TomaszBednorz/BLDC_Controller/Hardware/README.md

# Hardware - BLDC_Controller

Project designed in "Altium Designer" software. Involve custom BLDC motor controller and encoder based on Hall sensors.

## 1. Information
- The PMSM_Motor_Controller_v2_2023.pdf file contains the electrical schematics for BLDC controller,
- The Hall_board.pdf file contains the electrical schematics for encoder,
- The Altium_project directory contains the Altium designer project: electrical schematics, layout and more.

## 2. PCB sections
- Power supply,
- Microcontroller - Infineon XMC4300,
- EtherCAT,
- Gate driver,
- Encoder.

## 3. Visualization - BLDC controller
Front:

front

Back:

back

## 4. Visualisation - Custom encoder
Front:

front2

Back:

back2
