TomaszBednorz/BLDC_Controller/Software/README.md

# Software - BLDC_Controller

Dedicated software for the BLDC controller. **Software development is still in progress.**

## 1. TODO list
- [x] TMAG5170 Hall sensor driver
- [x] Motor position detection system
- [x] Hardware abstraction layers: Hall sensor, PWM, ADC
- [x] Motor control in the open loop control system - basic six-step commutation
- [ ] Motor control in the closed loop control system - PI controller
- [ ] Using BEMF (Back-electromotive force) in motor control system
