TomaszBednorz/BLDC_Controller/Hardware/Altium_project/PMSM_Motor_Controller_v2_2023.html

Reporting Options

# File in Newer Format

Date | : | 10.04.2023
Time | : | 15:40:49
Project name | : | C:\Users\Public\Documents\Altium\PMSM_Motor_Controller_v2_2023\PMSM_Motor_Controller_v2_2023.PrjPcb
Schematic documents | : | ECAT0_(IN).SchDoc

Version | Warning
22.3.0 | Custom diff pair suffixes are not supported in this version.

These files were generated in a later version of Altium Designer. Be aware that some data may have been added through functionality not available in your current version and will therefore not be available to you.
