TomaszBednorz/BLDC_Controller/Hardware/PMSM_Motor_Controller_v2_2023.pdf

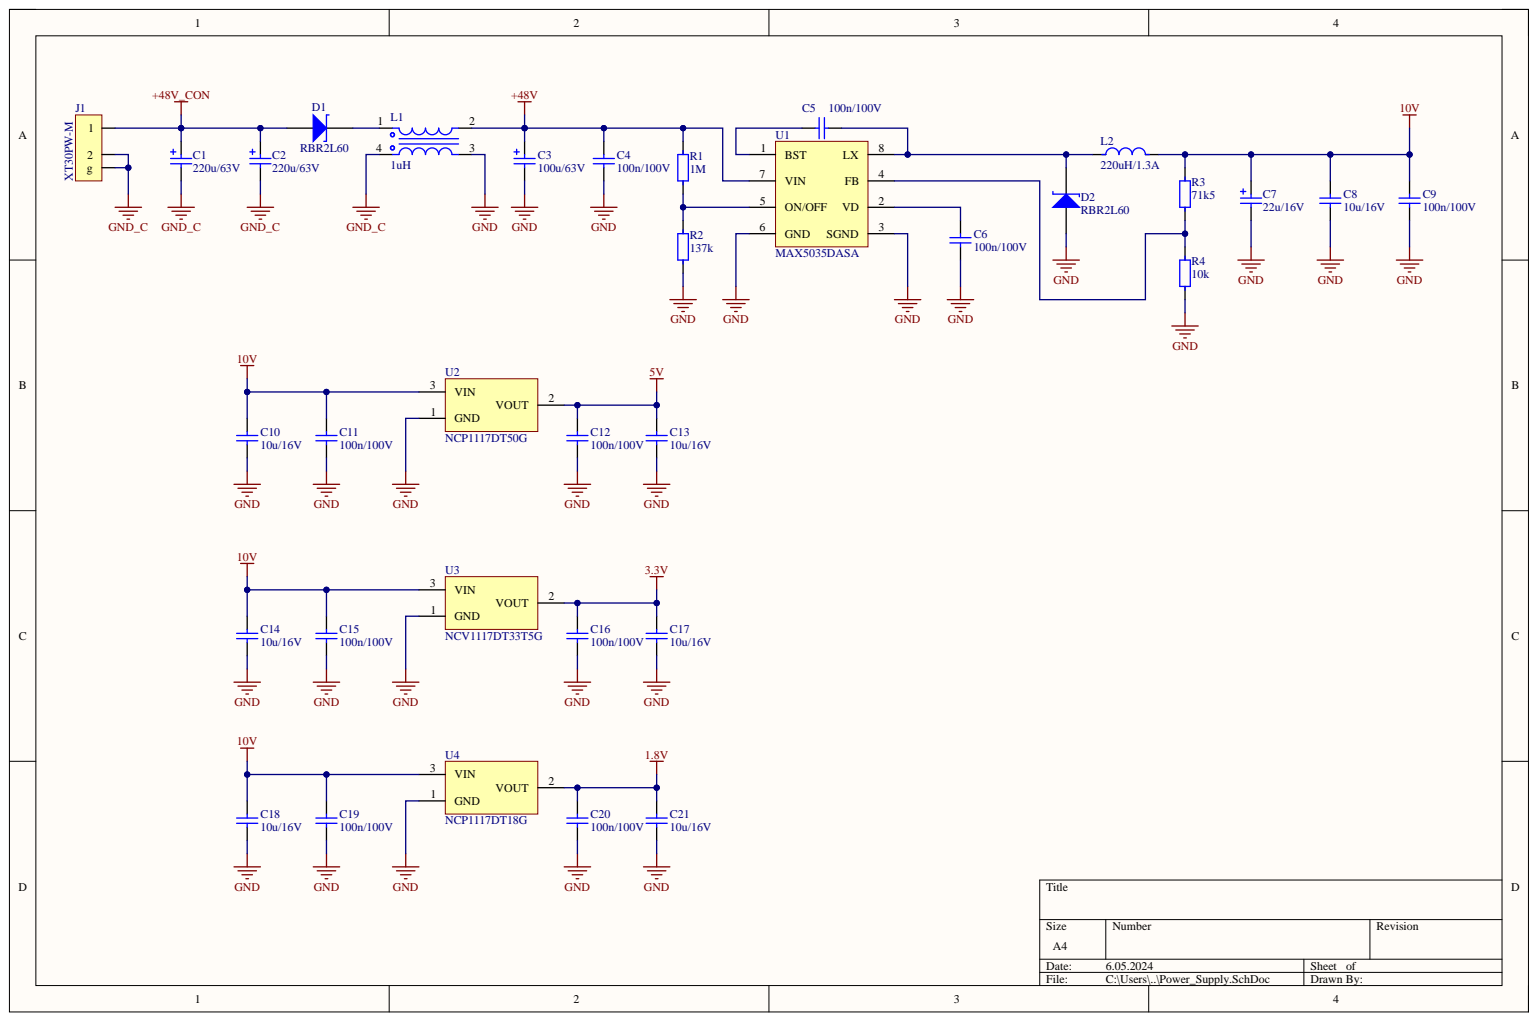
[picture p15: page 1]

VIN 7 VD

ON/OFF 5 | 2

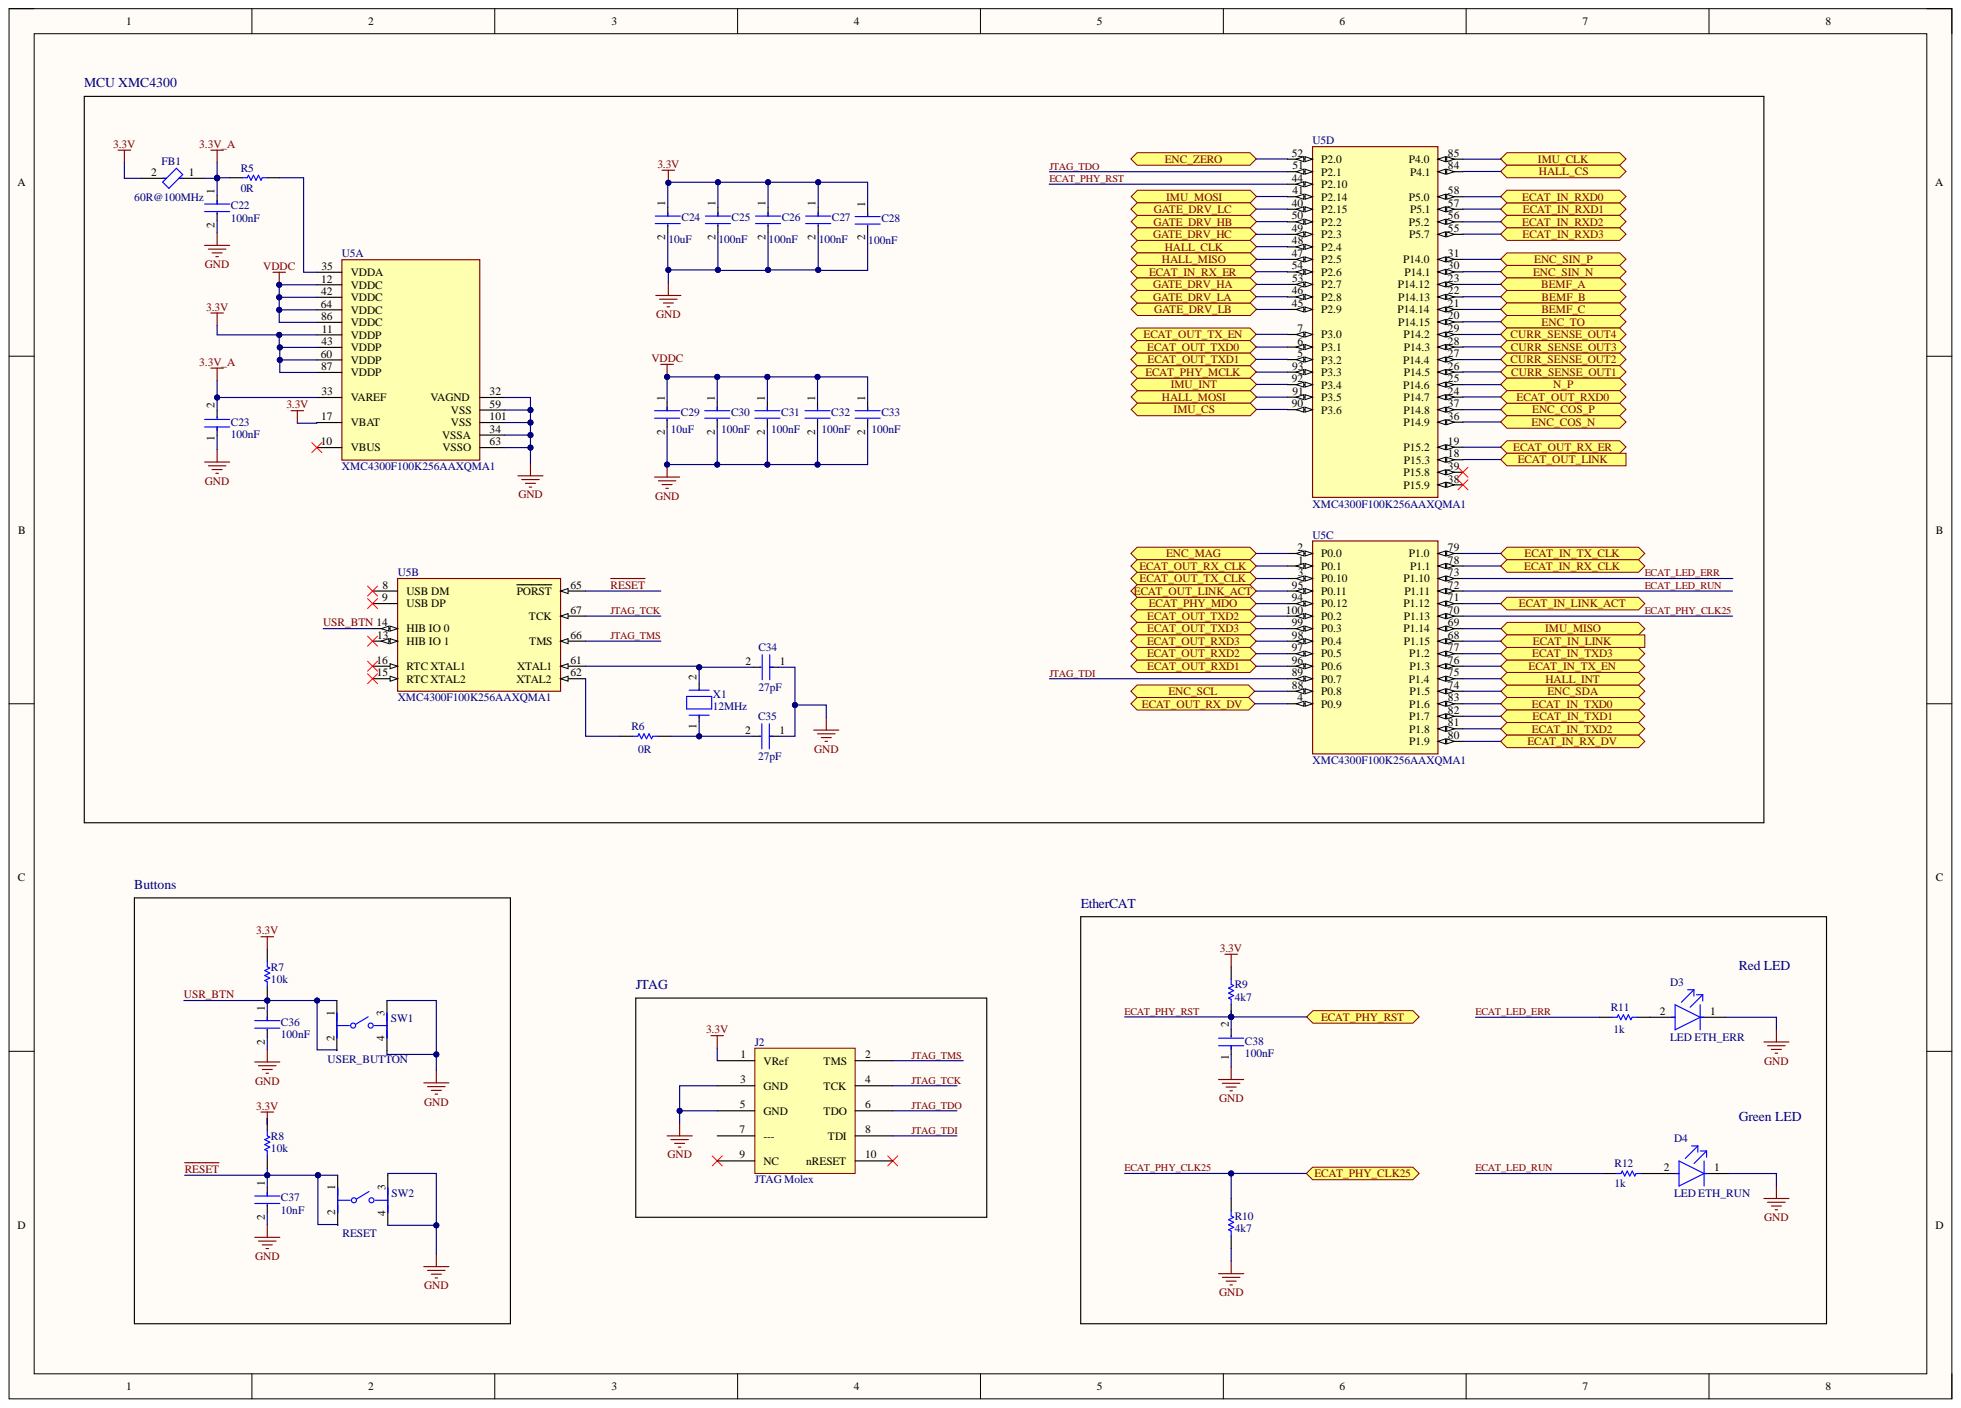
[picture p16: page 2]

VDDC 42
VDDC 64 | GND VDDC

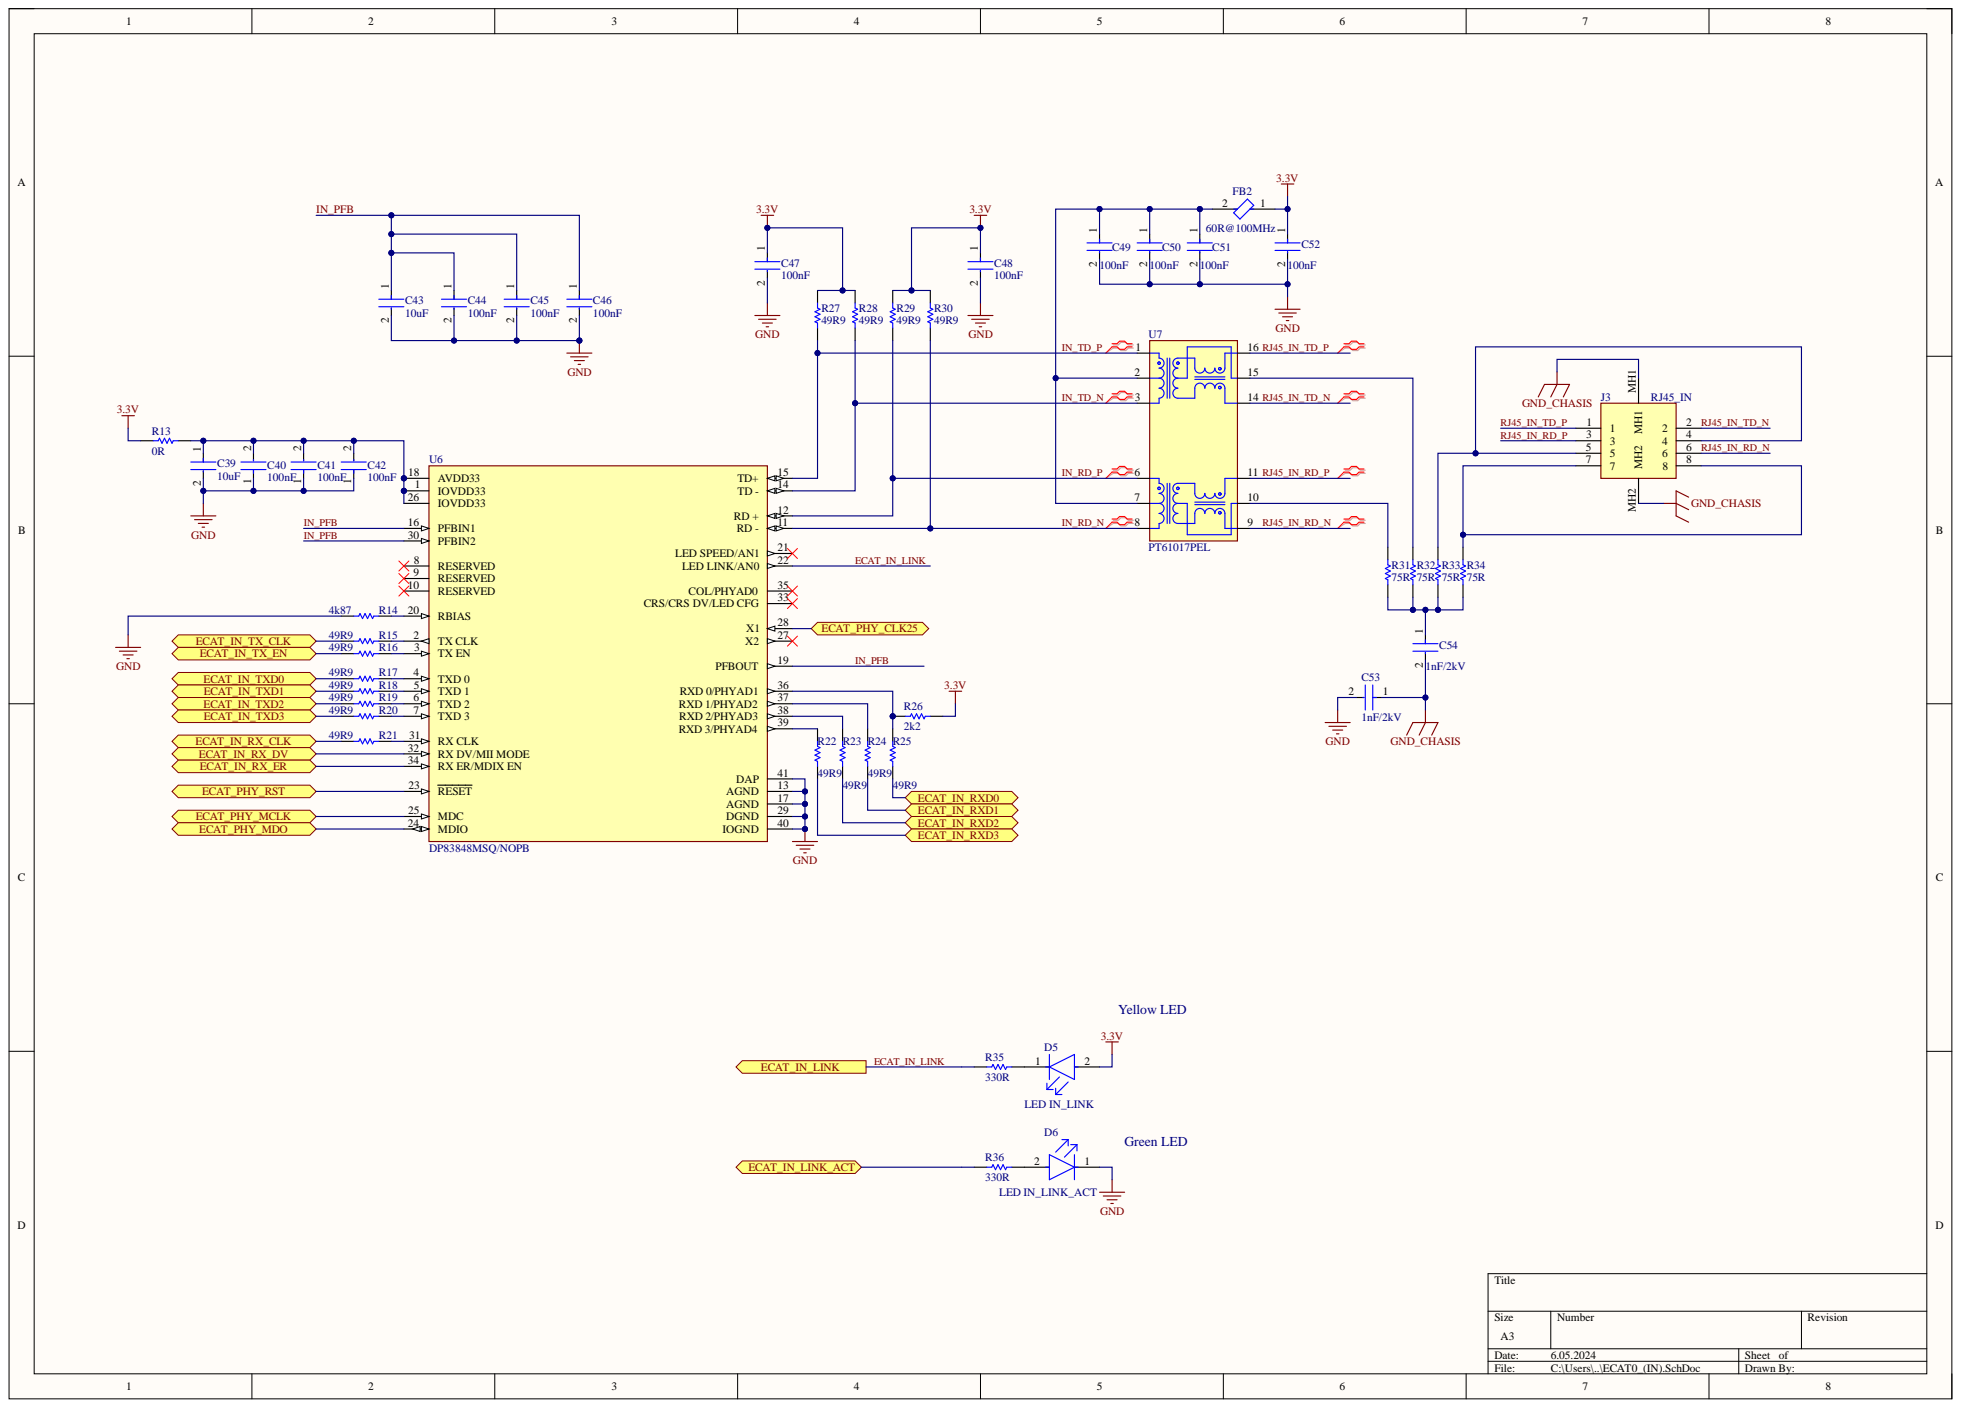
[picture p17: page 3]

RX CLK 31
RX DV/MII MODE 32
RX ER/MDIX EN 34

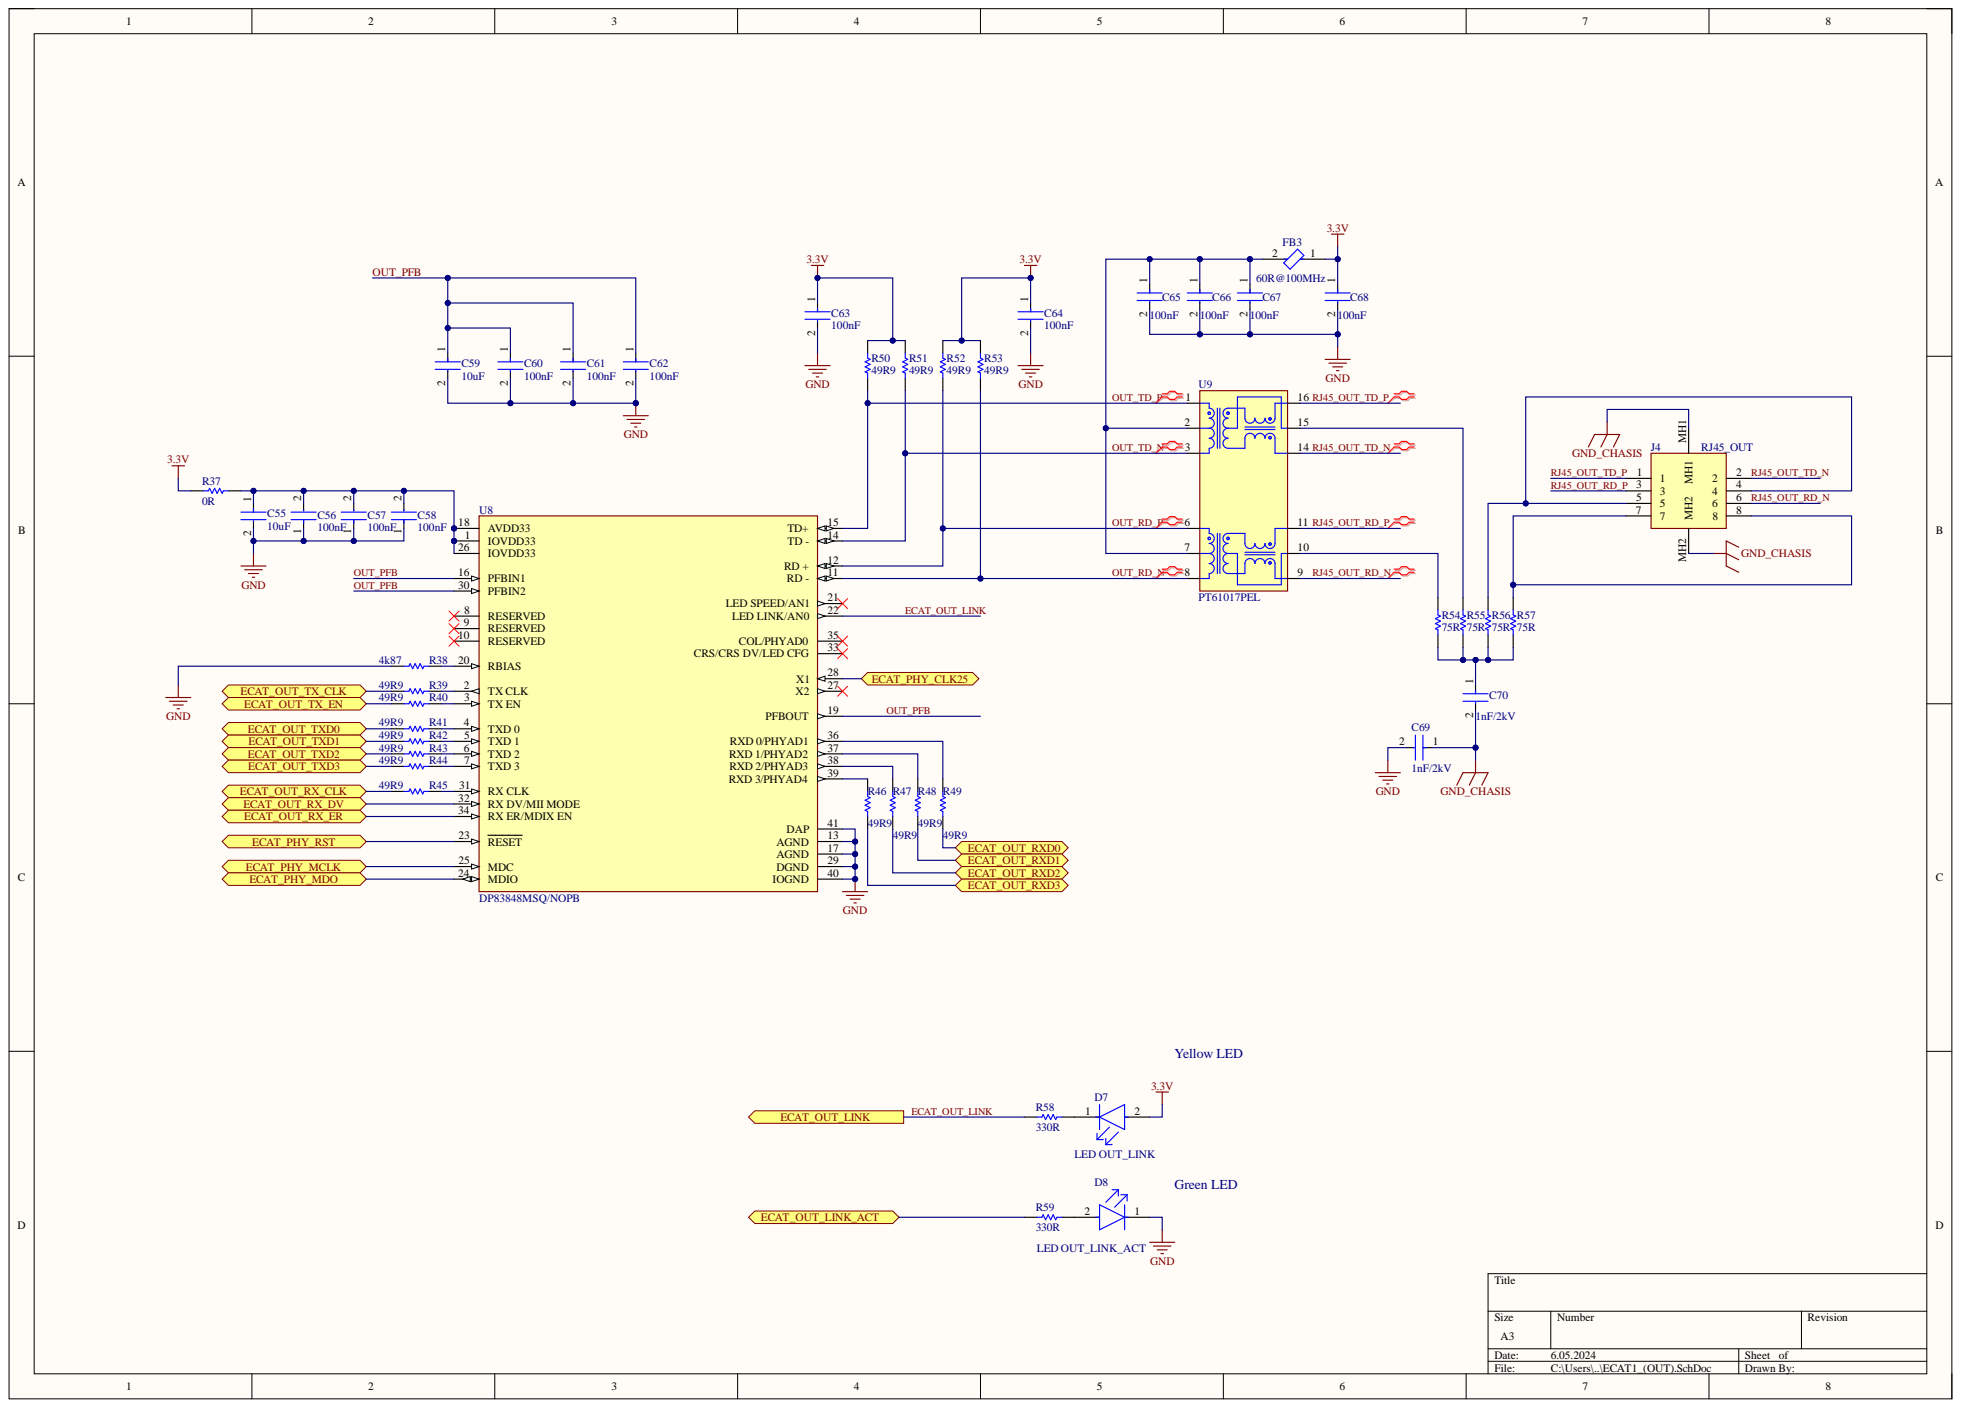
[picture p18: page 4]

RX CLK 31
RX DV/MII MODE 32
RX ER/MDIX EN 34

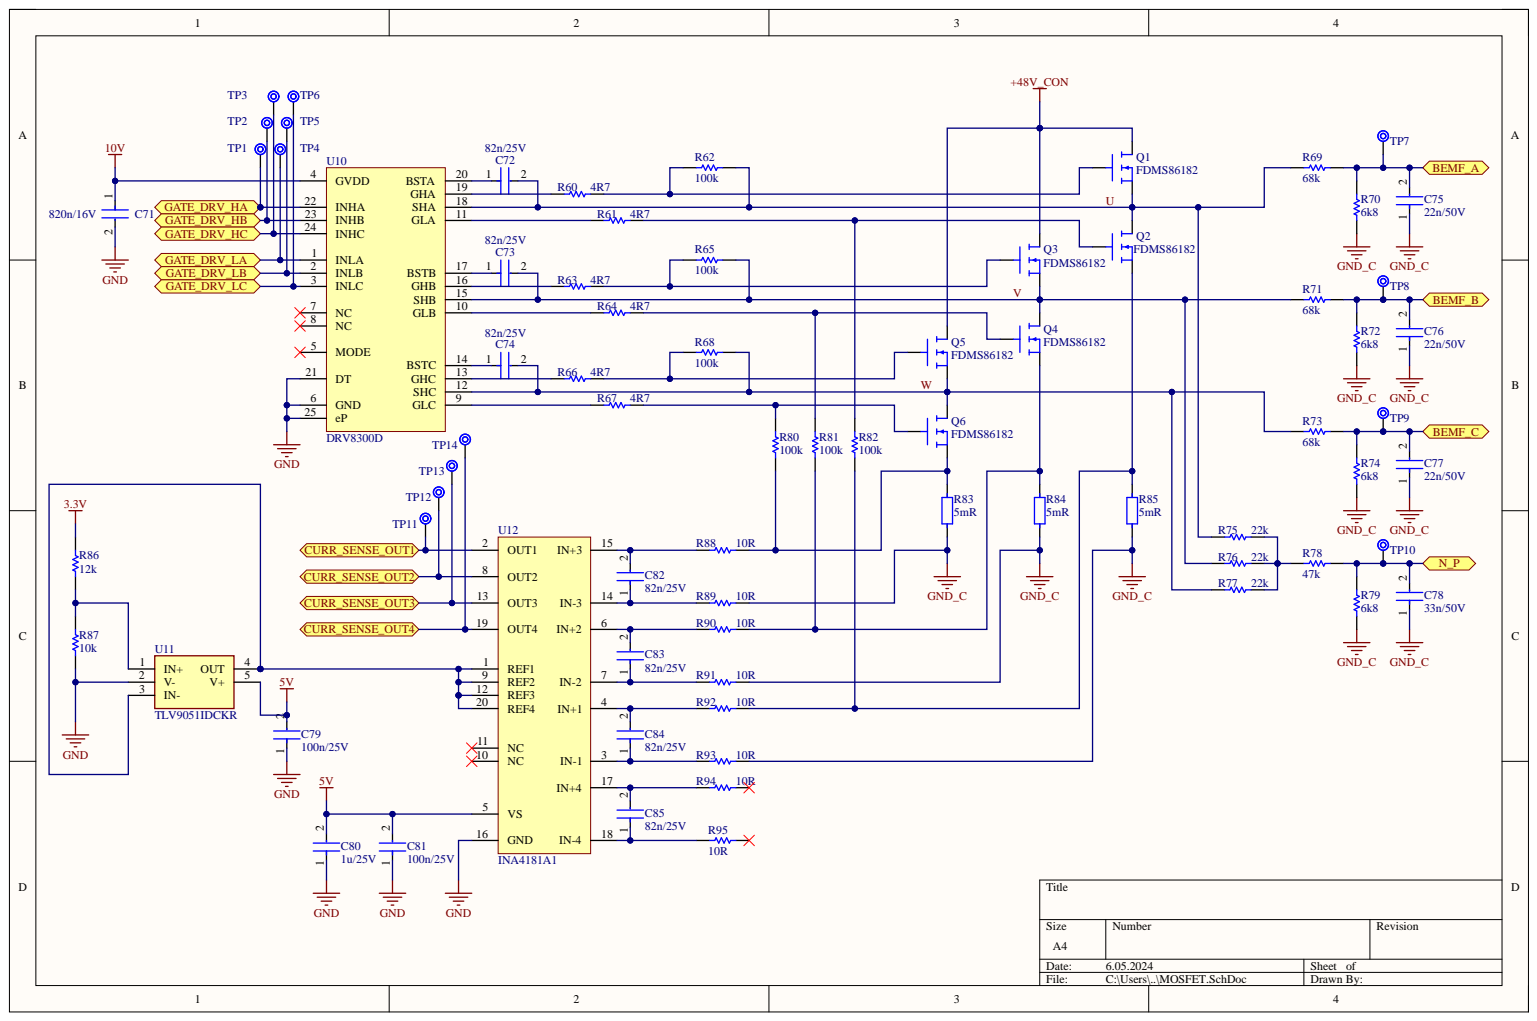
[picture p19: page 5]

INHB 23 | R61 4R7 | Q2 FDMS86182
INHC 24 | C73

R65 | | | FDMS86182

R64 4R7 | | Q4 FDMS86182

eP 25

9 | Q6 FDMS86182

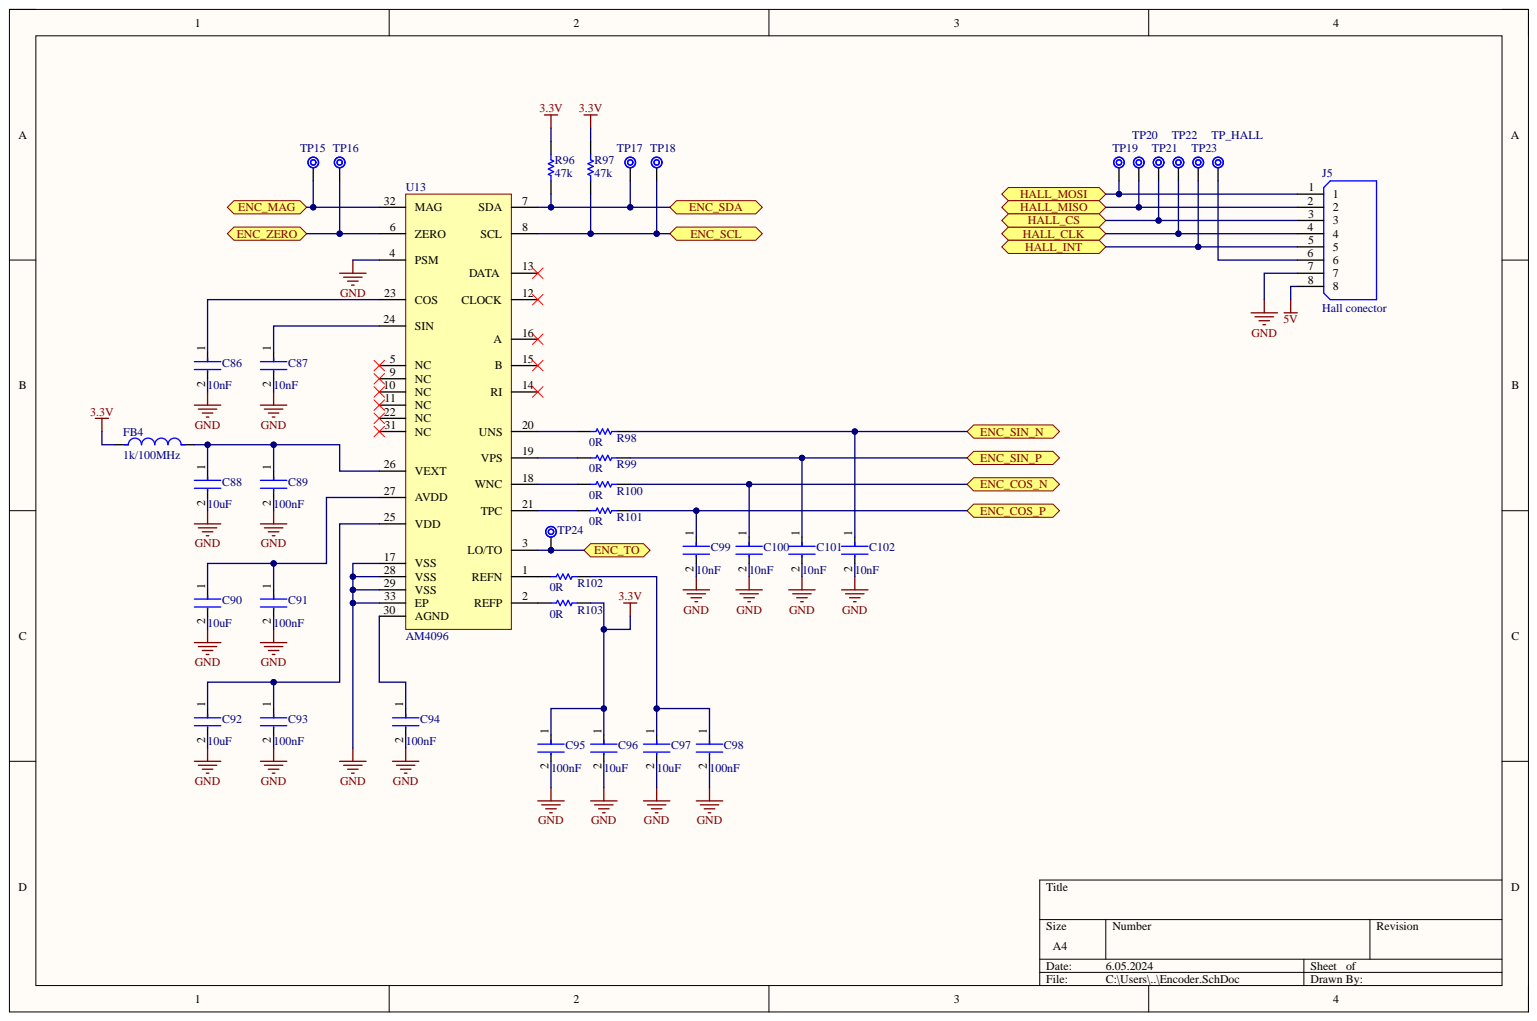
[picture p20: page 6]

VDD 25

VSS 28
VSS 29
EP 33
AGND 30

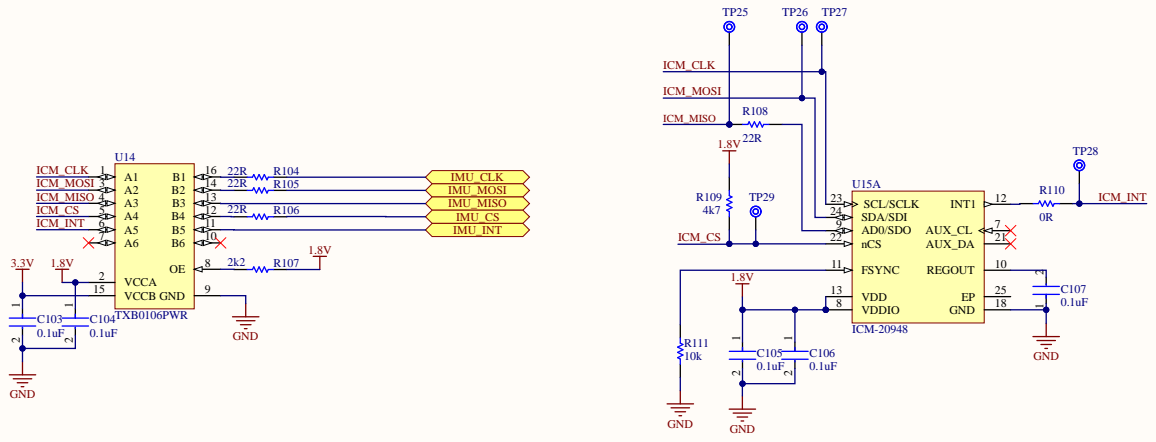
[picture p21: page 7]

ICM_MOSI

ICM_MIS O

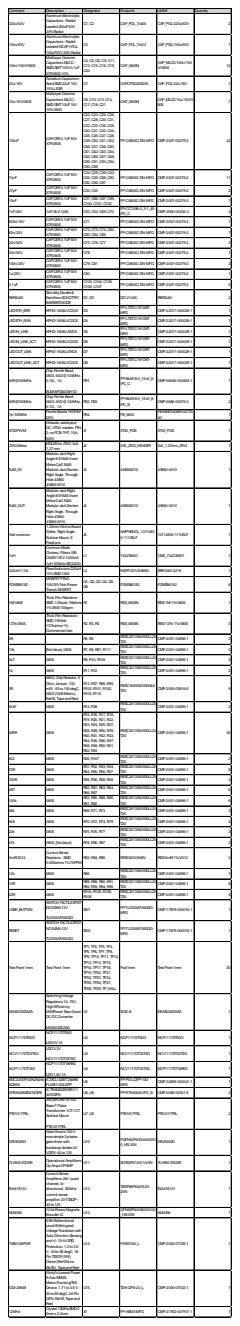
[picture p22: page 8]

100u/63V | AluminumElectrolytic Capacitors - Radial LeadedWCAP-ATUL 100uF63V20%Radial | C3 | CAP_POL_10x12 | CAP_POL/100u/63V | 1

100n/100V/0805 | Multilayer Ceramic Capacitors MLCC-SMD/SMT100V0.1uF X7R080510% | C4, C5, C6, C9, C11, C12, C15, C16, C19, C20 | CAP_0805N | CAP_MLCC/100n/100 V/0805 | 10

22u/16V | TantalumCapacitors -SolidSMD22uF16V 10%LESR | C7 | CAPCP3528X20N | CAP_POL/22u/16V | 1

10u/16V/0805 | Multilayer Ceramic Capacitors MLCC-SMD/SMT10UF16V 10%0805 | C8, C10, C13, C14, C17, C18, C21 | CAP_0805N | CAP_MLCC/10u/16V/0 805 | 7

100nF | CAPCER0.1UF50V X7R0805 | C22, C23, C25, C26, C27, C28, C30, C31, C32, C33, C36, C38, C40, C41, C42, C44, C45, C46, C47, C48, C49, C50, C51, C52, C56, C57, C58, C60, C61, C62, C63, C64, C65, C66, C67, C68, C89, C91, C93, C94, C95, C98 | FP-C0805C-DN-MFG | CMP-2007-00279-2 | 42

10uF | CAPCER0.1UF50V X7R0805 | C24, C29, C39, C43, C55, C59, C88, C90, C92, C96, C97 | FP-C0805C-DN-MFG | CMP-2007-00279-2 | 11

27pF | CAPCER0.1UF50V X7R0805 | C34, C35 | FP-C0805C-DN-MFG | CMP-2007-00279-2 | 2

10nF | CAPCER0.1UF50V X7R0805 | C37, C86, C87, C99, C100, C101, C102 | FP-C0805C-DN-MFG | CMP-2007-00279-2 | 7

1nF/2kV | 1nF/2kV/1206 | C53, C54, C69, C70 | FP-CC1206-0_3-1_45-IPC_C | CMP-2000-05436-2 | 4

820n/16V | CAPCER0.1UF50V X7R0805 | C71 | FP-C0805C-DN-MFG | CMP-2007-00279-2 | 1

82n/25V | CAPCER0.1UF50V X7R0805 | C72, C73, C74, C82, C83, C84, C85 | FP-C0805C-DN-MFG | CMP-2007-00279-2 | 7

22n/50V | CAPCER0.1UF50V X7R0805 | C75, C76, C77 | FP-C0805C-DN-MFG | CMP-2007-00279-2 | 3

33n/50V | CAPCER0.1UF50V X7R0805 | C78 | FP-C0805C-DN-MFG | CMP-2007-00279-2 | 1

100n/25V | CAPCER0.1UF50V X7R0805 | C79, C81 | FP-C0805C-DN-MFG | CMP-2007-00279-2 | 2

1u/25V | CAPCER0.1UF50V X7R0805 | C80 | FP-C0805C-DN-MFG | CMP-2007-00279-2 | 1

0.1uF | CAPCER0.1UF50V X7R0805 | C103, C104, C105, C106, C107 | FP-C0805C-DN-MFG | CMP-2007-00279-2 | 5

RBR2L60 | SchottkyDiodes& RectifiersSCHOTTKY BARRIERDIODE | D1, D2 | DO-214AC | RBR2L60 | 2

LEDETH_ERR | KPHD-1608LVCGCK | D3 | FP-LTST-C191GKT-MFG | CMP-22017-000029-1 | 1

LEDETH_RUN | KPHD-1608LVCGCK | D4 | FP-LTST-C191GKT-MFG | CMP-22017-000029-1 | 1

LEDIN_LINK | KPHD-1608LVSYCK | D5 | FP-LTST-C191GKT-MFG | CMP-22017-000029-1 | 1

LEDIN_LINK_ACT | KPHD-1608LVCGCK | D6 | FP-LTST-C191GKT-MFG | CMP-22017-000029-1 | 1

LEDOUT_LINK | KPHD-1608LVSYCK | D7 | FP-LTST-C191GKT-MFG | CMP-22017-000029-1 | 1

LEDOUT_LINK_ACT | KPHD-1608LVCGCK | D8 | FP-LTST-C191GKT-MFG | CMP-22017-000029-1 | 1

60R@100MHz | ChipFerriteBead, 0603, 60Ω@100MHz, 0.1Ω, , 1A BLM18PG600SH1D | FB1 | FP-BLM18-0_15-t0_8-IPC_C | CMP-06046-002563-1 | 1

60R@100MHz | ChipFerriteBead, 0603, 60Ω@100MHz, 0.1Ω, , 1A | FB2, FB3 | FP-BLM18-0_15-t0_8-IPC_B | CMP-0686-00575-3 | 2

1k/100MHz | FerriteBeads1KOHM 25% | FB4 | FB_0603 | FB/MMZ1608B102CTA 00 | 1

XT30PW-M | Gniazdo; zasilające DC; XT30; męskie; PIN: 2; naPCB; THT; 15A; 500V | J1 | XT30_PCB | XT30_PCB | 1

JTAGMolex | MOLEXfor JTAG, 5x2, 1,27mm | J2 | 2X5_JTAG_HEADER | 5x2_1,27mm_JTAG | 1

RJ45_IN | Modular JackRight Angle8/8RJ45Invert MolexCat3RJ45 Modular JackSocket, Right Angle, Through Hole43860 43860-0010 | J3 | 438600010 | 43860-0010 | 1

RJ45_OUT | Modular JackRight Angle8/8RJ45Invert MolexCat3RJ45 Modular JackSocket, Right Angle, Through Hole43860 43860-0010 | J4 | 438600010 | 43860-0010 | 1

Hall conector | 1.25mmWire toBoard Wafer, Right Angle, SurfaceMount, 8 Positions | J5 | AMPHENOL_1011483 0-11108LF | 10114830-11108LF | 1

1uH | CommonMode Chokes/ FiltersWE-CNSW18121200mA 1uH100kHzAECQ200 | L1 | 744235601 | CMC_744235601 | 1

220uH/1.3A | FixedInductors 220uH 10%SMD1260 | L2 | INDP125125X65N | SRR1260-221K | 1

FDMS86182 | MOSFETPTNG 100/20VNchPower TrenchMOSFET | Q1, Q2, Q3, Q4, Q5, Q6 | FDMS86182 | FDMS86182 | 6

1M/0805 | ThickFilm Resistors -SMD.125watt 1Mohms 1%0805100ppm | R1 | RES_0805N | RES/1M/1%/0805 | 1

137k/0805 | ThickFilm Resistors -SMD1/8Watt 137kohms1% Commercial Use | R2, R3, R4 | RES_0805N | RES/137k/1%/0805 | 3

0R | | R5, R6 | RESC2013X50X30LL20 T20 | CMP-2001-04896-1 | 2

10k | [NoValue], 0805 | R7, R8, R87, R111 | RESC2013X50X30LL20 T20 | CMP-2001-04896-1 | 4

4k7 | 0805 | R9, R10, R109 | RESC2013X50X30LL20 T20 | CMP-2001-04896-1 | 3

1k | 0805 | R11, R12 | RESC2013X50X30LL20 T20 | CMP-2001-04896-1 | 2

0R | 0603, ChipResistor, 0 Ohm, Jumper, 100 mW, -55to155degC, 0603(1608Metric), RoHS, TapeandReel | R13, R37, R98, R99, R100, R101, R102, R103, R110 | RESC1609X50X30NL8 T20 | CMP-2000-03816-5 | 9

4k87 | 0805 | R14, R38 | RESC2013X50X30LL20 T20 | CMP-2001-04896-1 | 2

49R9 | 0805 | R15, R16, R17, R18, R19, R20, R21, R22, R23, R24, R25, R27, R28, R29, R30, R39, R40, R41, R42, R43, R44, R45, R46, R47, R48, R49, R50, R51, R52, R53 | RESC2013X50X30LL20 T20 | CMP-2001-04896-1 | 30

2k2 | 0805 | R26, R107 | RESC2013X50X30LL20 T20 | CMP-2001-04896-1 | 2

75R | 0805 | R31, R32, R33, R34, R54, R55, R56, R57 | RESC2013X50X30LL20 T20 | CMP-2001-04896-1 | 8

330R | 0805 | R35, R36, R58, R59 | RESC2013X50X30LL20 T20 | CMP-2001-04896-1 | 4

4R7 | 0805 | R60, R61, R63, R64, R66, R67 | RESC2013X50X30LL20 T20 | CMP-2001-04896-1 | 6

100k | 0805 | R62, R65, R68, R80, R81, R82 | RESC2013X50X30LL20 T20 | CMP-2001-04896-1 | 6

68k | 0805 | R69, R71, R73 | RESC2013X50X30LL20 T20 | CMP-2001-04896-1 | 3

6k8 | 0805 | R70, R72, R74, R79 | RESC2013X50X30LL20 T20 | CMP-2001-04896-1 | 4

22k | 0805 | R75, R76, R77 | RESC2013X50X30LL20 T20 | CMP-2001-04896-1 | 3

47k | 0805, [NoValue] | R78, R96, R97 | RESC2013X50X30LL20 T20 | CMP-2001-04896-1 | 3

5mR/2512 | Current Sense Resistors - SMD 0.005ohms1%75PPM | R83, R84, R85 | RESC6432X08N | RES/5mR/1%/2512 | 3

12k | 0805 | R86 | RESC2013X50X30LL20 T20 | CMP-2001-04896-1 | 1

10R | 0805 | R88, R89, R90, R91, R92, R93, R94, R95 | RESC2013X50X30LL20 T20 | CMP-2001-04896-1 | 8

22R | 0805 | R104, R105, R106, R108 | RESC2013X50X30LL20 T20 | CMP-2001-04896-1 | 4

USER_BUTTON | SWITCHTACTILESPST-NO50MA12V TL3305AF260QG | SW1 | FP-TL3305AF260QG-MFG | CMP-17879-000010-1 | 1

RESET | SWITCHTACTILESPST-NO50MA12V TL3305AF260QG | SW2 | FP-TL3305AF260QG-MFG | CMP-17879-000010-1 | 1

Test Point 1mm | Test Point 1mm | TP1, TP2, TP3, TP4, TP5, TP6, TP7, TP8, TP9, TP10, TP11, TP12, TP13, TP14, TP15, TP16, TP17, TP18, TP19, TP20, TP21, TP22, TP23, TP24, TP25, TP26, TP27, TP28, TP29, TP_HALL | Pad1mm | Test Point 1mm | 30

MAX5035DASA | SwitchingVoltage Regulators 1A, 76V, High-Efficiency MAXPower Step-Down DC-DCConverter MAX5035DASA | U1 | SOIC-8 | MAX5035DASA | 1

NCP1117DT50G | NCP1117DT50G LDO5V1A | U2 | NCP1117DT50G | NCP1117DT50G | 1

NCV1117DT33T5G | LDO3.3V NCV1117DT33T5G | U3 | NCV1117DT33T5G | NCV1117DT33T5G | 1

NCP1117DT18G | NCP1117DT18RKG LDO1,8V1A | U4 | NCV1117DT33T5G | NCP1117DT18RKG | 1

XMC4300F100K256AA XQMA1 | ICMCU32BIT256KB FLASH100LQFP | U5 | FP-PG-LQFP-100-MFG | CMP-32808-000041-1 | 1

DP83848MSQ/NOPB | ICTRANSCEIVER1/1 40WQFN | U6, U8 | FP-RTA0040A-IPC_B | CMP-0058-00351-5 | 2

PT61017PEL | 350µHLAN10/100 Base-TPulse Transformer 1CT:1CT SurfaceMount PT61017PEL | U7, U9 | PT61017PEL | PT61017PEL | 2

DRV8300D | GateDrivers 100-V maxsimple3-phase gatedriver with bootstrapdiodes24-VQFN-40to125 | U10 | PQFN50P400X400X10 0_HS-25N | DRV8300D | 1

TLV9051IDCKR | Operational Amplifiers -OpAmpsOPAMP | U11 | SOT65P210X110-5N | TLV9051IDCKR | 1

INA4181A1 | Current Sense Amplifiers 26V, quad channel, bi-directional, 350kHz current sense amplifier 20-TSSOP-40to125 | U12 | TSOP65P640X120-20N | INA4181A1 | 1

AM4096 | 12bit RotaryMagnetic Encoder IC | U13 | QFN65P600X600X100 _HS-33N | AM4096 | 1

TXB0106PWR | 6-Bit Bidirectional Level-Shiftingand VoltageTranslator with Auto-DirectionSensing and+/- 15-kVESD Protection, 1.2to3.6 V, -40to85degC, 16-PinTSSOP(PW), Green(RoHS&no Sb/Br), TapeandReel | U14 | PW0016A_L | CMP-2000-07336-1 | 1

ICM-20948 | World’sLowest Power 9-Axis MEMS MotionTracking(TM) Device, 1.71to3.6V, -40to85degC, 24-Pin QFN, RoHS, Tapeand Reel | U15 | TDK-QFN-24_L | CMP-2000-07532-1 | 1

12MHz | Crystal 12MHzSMD-2 5mmx3.2mm | X1 | FP-ABM3-MFG | CMP-27762-007917-1 | 1
