TomaszBednorz/BLDC_Controller/(list of files, drawings)

Other design files:
Hardware/Altium_project/43860-0010_RJ45.SchLib
Hardware/Altium_project/438600010_RJ45.PcbLib
Hardware/Altium_project/2023960807_molex/2023960807.SchLib
Hardware/Altium_project/2023960807_molex/MOLEX_2023960807.PcbLib
Hardware/Altium_project/CAPACITOR.SchLib
Hardware/Altium_project/CONNECTOR.SchLib
Hardware/Altium_project/DIODE.SchLib
Hardware/Altium_project/ECAT0_(IN).SchDoc
Hardware/Altium_project/ECAT1_(OUT).SchDoc
Hardware/Altium_project/Encoder.SchDoc
Hardware/Altium_project/IC.SchLib
Hardware/Altium_project/IMU.SchDoc
Hardware/Altium_project/INDUCTOR.SchLib
Hardware/Altium_project/MCU.SchDoc
Hardware/Altium_project/MOSFET.SchDoc
Hardware/Altium_project/OTHER.SchLib
Hardware/Altium_project/PMSM_Motor_Controller_v2_2023.PrjPcb
Hardware/Altium_project/Power_Supply.SchDoc
Hardware/Altium_project/RESISTOR.SchLib
Hardware/Altium_project/SOT65P210X110-5N_Amp.PcbLib
Hardware/Altium_project/TLV9051IDCKR_Amp.SchLib
