TomaszBednorz/BLDC_Controller/Software/APP/App_Hall/Src/app_hall.c

/***********************************************************************************************************
 ********************************************* Included files **********************************************
 ***********************************************************************************************************/

#include "app_hall.h"
#include "app_hall_cfg.h"

/***********************************************************************************************************
 ************************************************* Defines *************************************************
 ***********************************************************************************************************/

#define APP_HALL_360_DEG            (int16_t)(0x1680)
#define APP_HALL_0_DEG              (int16_t)(0x0000)

// comm 4bity na likwidaje przecinka i 2 buty to dzielenie przez 4
#define APP_HALL_ANGLE_DIV_4        (6U)

#define APP_HALL_VALIDATE_IDX(idx)   (idx < APP_HALL_LUT_SIZE) ? (idx) : (90U)

/***********************************************************************************************************
 *********************************************** Data types ************************************************
 ***********************************************************************************************************/

/***********************************************************************************************************
 **************************************** Local function prototypes ****************************************
 ***********************************************************************************************************/

static void App_Hall_UpdateAngleSensor0(void);
static int16_t App_Hall_ValidateAngle(int16_t ang);

/***********************************************************************************************************
 ******************************************** Exported objects *********************************************
 ***********************************************************************************************************/

/***********************************************************************************************************
 ********************************************* Local objects ***********************************************
 ***********************************************************************************************************/

int16_t App_Hall_Angle[APP_HALL_SENSOR_MAX];

/***********************************************************************************************************
 ******************************************* Exported functions ********************************************
 ***********************************************************************************************************/

/***********************************************************************************************************
 ******************************************** Local functions **********************************************
 ***********************************************************************************************************/

#include "UART/uart.h"
#include <stdio.h>
#include <string.h>
#include "DIGITAL_IO/digital_io.h"
#include "app_bldc.h"

extern uint16_t bemf_a[10000];
extern uint16_t bemf_b[10000];
extern uint16_t bemf_c[10000];
extern uint16_t bemf_n[10000];
extern uint32_t cnt;

uint32_t int_cnt = 0;

char buffer[50];



void App_Hall_Task(void)
{
    // App_Hall_UpdateAngleSensor0();

    // if(cnt == 10000)
    // {
    //     App_Bldc_SetState(APP_BLDC_STATE_OFF);

    //     if(int_cnt < 10000)
    //     {
    //         sprintf(buffer, "%d %d %d %d\r\n", bemf_a[int_cnt], bemf_b[int_cnt], bemf_c[int_cnt], bemf_n[int_cnt]);
    //         UART_StartTransmitIRQ(&UART_0, (uint8_t*)buffer, (uint32_t)strlen(buffer));
    //         int_cnt++;
    //     }
    // }



}

static void App_Hall_UpdateAngleSensor0(void)
{
    uint8_t lut_idx;

    /* Sensor 0 */
    lut_idx = APP_HALL_VALIDATE_IDX(Hal_Hall_Results[APP_HALL_SENSOR_0].angle >> APP_HALL_ANGLE_DIV_4);
    App_Hall_Angle[APP_HALL_SENSOR_0] = App_Hall_ValidateAngle((int16_t)Hal_Hall_Results[APP_HALL_SENSOR_0].angle - App_Hall_AngleCorrectionLUT[lut_idx]);
}

static int16_t App_Hall_ValidateAngle(int16_t ang)
{
    int16_t ret_ang = 0;

    if(ang < APP_HALL_0_DEG)
    {
        ret_ang = ang + APP_HALL_360_DEG;
    }
    else if(ang > APP_HALL_360_DEG)
    {
        ret_ang = ang - APP_HALL_360_DEG;
    }
    else
    {
        ret_ang = ang;
    }

    return ret_ang;
}
