TomaszBednorz/BLDC_Controller/Software/DRV/Int_Manager/Src/int_manager.c

/***********************************************************************************************************
 ********************************************* Included files **********************************************
 ***********************************************************************************************************/

#include "SPI_MASTER/spi_master.h"
#include "ADC_MEASUREMENT_ADV/adc_measurement_adv.h"
#include "INTERRUPT/interrupt.h"

#include "int_manager.h"
#include "tmag.h"
#include "hal_adc.h"
#include "app_bldc.h"

/***********************************************************************************************************
 ************************************************* Defines *************************************************
 ***********************************************************************************************************/

/***********************************************************************************************************
 *********************************************** Data types ************************************************
 ***********************************************************************************************************/

/***********************************************************************************************************
 **************************************** Local function prototypes ****************************************
 ***********************************************************************************************************/

uint32_t volatile global_time = 0U;
bool volatile global_flag = false;

/***********************************************************************************************************
 ******************************************** Exported objects *********************************************
 ***********************************************************************************************************/


#include "DIGITAL_IO/digital_io.h"


void SPI_IrqRxCallback(void)
{
	// DIGITAL_IO_SetOutputHigh(&PIN_DEBUG);
	Tmag_TransferReady();
	// DIGITAL_IO_SetOutputLow(&PIN_DEBUG);
}

void ADC_IrqGroup0Callback(void)
{
	// DIGITAL_IO_SetOutputHigh(&PIN_DEBUG);
	Hal_Adc_ConversionReady(HAL_ADC_GROUP_0);
	// DIGITAL_IO_SetOutputLow(&PIN_DEBUG);
}

void ADC_IrqGroup1Callback(void)
{
		// DIGITAL_IO_SetOutputHigh(&PIN_DEBUG);
	Hal_Adc_ConversionReady(HAL_ADC_GROUP_1);
	// DIGITAL_IO_SetOutputLow(&PIN_DEBUG);
}

void TIM_IrqGateDrvCallback(void)
{
	App_Bldc_TimerTask();
}

void TIM_IrqSystemCallback(void)
{
	global_time++;
	global_flag = true;
}

/***********************************************************************************************************
 ********************************************* Local objects ***********************************************
 ***********************************************************************************************************/

/***********************************************************************************************************
 ******************************************* Exported functions ********************************************
 ***********************************************************************************************************/

/***********************************************************************************************************
 ******************************************** Local functions **********************************************
 ***********************************************************************************************************/
