TomaszBednorz/BLDC_Controller/Software/APP/App_Hall/Src/app_hall.h

#ifndef _APP_HALL_H_
#define _APP_HALL_H_

/***********************************************************************************************************
 ********************************************* Included files **********************************************
 ***********************************************************************************************************/

#include "hal_hall.h"

/***********************************************************************************************************
 ************************************************* Defines *************************************************
 ***********************************************************************************************************/

#define APP_HALL_SENSOR_0     (0U)
#define APP_HALL_SENSOR_1     (1U)
#define APP_HALL_SENSOR_MAX   (HAL_HALL_SENSOR_NBR_MAX)

#define APP_HALL_TASK_PERIOD  (10)  /* 1 = 100us */
#define APP_HALL_TASK_OFFSET  (9)

/***********************************************************************************************************
 *********************************************** Data types ************************************************
 ***********************************************************************************************************/

/***********************************************************************************************************
 ********************************************* Exported objects ********************************************
 ***********************************************************************************************************/

extern int16_t App_Hall_Angle[APP_HALL_SENSOR_MAX];

/***********************************************************************************************************
 ************************************** Exported function prototypes ***************************************
 ***********************************************************************************************************/

void App_Hall_Task(void);

#endif  /* _APP_HALL_H_ */
