TomaszBednorz/BLDC_Controller/Software/DRV/Int_Manager/Src/int_manager.h

#ifndef _INT_MANAGER_H_
#define _INT_MANAGER_H_

/***********************************************************************************************************
 ********************************************* Included files **********************************************
 ***********************************************************************************************************/

#include "stdint.h"

/***********************************************************************************************************
 ************************************************* Defines *************************************************
 ***********************************************************************************************************/

/***********************************************************************************************************
 *********************************************** Data types ************************************************
 ***********************************************************************************************************/

/***********************************************************************************************************
 ********************************************* Exported objects ********************************************
 ***********************************************************************************************************/

extern uint32_t volatile global_time;
extern bool volatile global_flag;

/***********************************************************************************************************
 ************************************** Exported function prototypes ***************************************
 ***********************************************************************************************************/

#endif  /* _INT_MANAGER_H_ */
