TomaszBednorz/BLDC_Controller/Software/HAL/Hal_Adc/Src/hal_adc.h

#ifndef _HAL_ADC_H_
#define _HAL_ADC_H_

/***********************************************************************************************************
 ********************************************* Included files **********************************************
 ***********************************************************************************************************/

#include <stdint.h>
#include "hal_adc.h"
#include "hal_adc_cfg.h"

/***********************************************************************************************************
 ************************************************* Defines *************************************************
 ***********************************************************************************************************/

/***********************************************************************************************************
 *********************************************** Data types ************************************************
 ***********************************************************************************************************/

/***********************************************************************************************************
 ********************************************* Exported objects ********************************************
 ***********************************************************************************************************/

/***********************************************************************************************************
 ************************************** Exported function prototypes ***************************************
 ***********************************************************************************************************/

void Hal_Adc_ConversionReady(uint8_t adc_group);
void Hal_Adc_GetData(Hal_Adc_Instance_t data_type, uint16_t* buffer);

#endif  /* _HAL_ADC_H_ */
