TomaszBednorz/BLDC_Controller/Software/HAL/Hal_GateDrv/Src/hal_gate_drv.h

#ifndef _HAL_GATE_DRV_H_
#define _HAL_GATE_DRV_H_

/***********************************************************************************************************
 ********************************************* Included files **********************************************
 ***********************************************************************************************************/

#include <stdint.h>

/***********************************************************************************************************
 ************************************************* Defines *************************************************
 ***********************************************************************************************************/

/***********************************************************************************************************
 *********************************************** Data types ************************************************
 ***********************************************************************************************************/

typedef enum
{
    HAL_GATE_DRV_SIGNAL_HA,
    HAL_GATE_DRV_SIGNAL_HB,
    HAL_GATE_DRV_SIGNAL_HC,
    HAL_GATE_DRV_SIGNAL_LA,
    HAL_GATE_DRV_SIGNAL_LB,
    HAL_GATE_DRV_SIGNAL_LC,
    HAL_GATE_DRV_SIGNAL_MAX
}Hal_GateDrv_Signal_t;

typedef enum
{
    HAL_GATE_DRV_PINS_PASSIVE_LEVEL_STANDARD,
    HAL_GATE_DRV_PINS_PASSIVE_LEVEL_INVERTED,  /* L* singnals outputs inverted, valid only in current configuration */
    HAL_GATE_DRV_PINS_PASSIVE_LEVEL_MAX
}Hal_GateDrv_PinsPassiveLevel_t;

/***********************************************************************************************************
 ********************************************* Exported objects ********************************************
 ***********************************************************************************************************/

/***********************************************************************************************************
 ************************************** Exported function prototypes ***************************************
 ***********************************************************************************************************/

void Hal_GateDrv_Init(void);
void Hal_GateDrv_SetPwmFreq(uint32_t freq);
void Hal_GateDrv_SetPwmDutyCycle(Hal_GateDrv_Signal_t signal, uint32_t duty_cycle);
// void Hal_GateDrv_SetPinsPassiveLevel(Hal_GateDrv_PinsPassiveLevel_t passive_level);

#endif  /* _HAL_GATE_DRV_H_ */
