TomaszBednorz/BLDC_Controller/Software/HAL/Hal_Hall/Src/hal_hall.h

#ifndef _HAL_HALL_H_
#define _HAL_HALL_H_

/***********************************************************************************************************
 ********************************************* Included files **********************************************
 ***********************************************************************************************************/

#include "stdint.h"

/***********************************************************************************************************
 ************************************************* Defines *************************************************
 ***********************************************************************************************************/

#define HAL_HALL_SENSOR_NBR_MAX     (2U)

#define HAL_HALL_TASK_PERIOD  (1)  /* 1 = 100us */
#define HAL_HALL_TASK_OFFSET  (0)

/***********************************************************************************************************
 *********************************************** Data types ************************************************
 ***********************************************************************************************************/

typedef struct 
{
    int16_t x;
    int16_t y;
    int16_t z;
    uint16_t angle;
}Hal_Hall_Results_t;

/***********************************************************************************************************
 ********************************************* Exported objects ********************************************
 ***********************************************************************************************************/

extern Hal_Hall_Results_t Hal_Hall_Results[HAL_HALL_SENSOR_NBR_MAX];

/***********************************************************************************************************
 ************************************** Exported function prototypes ***************************************
 ***********************************************************************************************************/

void Hal_Hall_Init(void);
void Hal_Hall_Task(void);
void Hal_Hall_TransmissionCompletedCallback(void);

#endif  /* _HAL_HALL_H_ */
