TomaszBednorz/BLDC_Controller/Software/DRV/Tmag5170/Cfg/tmag_cfg.h

#ifndef _TMAG_CFG_H_
#define _TAMG_CFG_H_

/***********************************************************************************************************
 ********************************************* Included files **********************************************
 ***********************************************************************************************************/

#include "tmag_reg.h"
#include "tmag_if.h"
#include "DAVE.h"

/***********************************************************************************************************
 ************************************************* Defines *************************************************
 ***********************************************************************************************************/

/***********************************************************************************************************
 *********************************************** Data types ************************************************
 ***********************************************************************************************************/

/* 
 * TMAG5170 configuration structure
 */
typedef struct 
{
    Tmag_RegDeviceConfig_t device;
    Tmag_RegSensorConfig_t sensor;
    Tmag_RegSystemConfig_t system;
    Tmag_RegAlertConfig_t alert;
    Tmag_RegXThrxConfig_t x_thrx;
    Tmag_RegYThrxConfig_t y_thrx;
    Tmag_RegZThrxConfig_t z_thrx;
    Tmag_RegTThrxConfig_t t_thrx;
    Tmag_RegMagGainConfig_t mag_gain;
    void (*data_transfer_start)(uint8_t* tx_data_ptr, uint8_t* rx_data_ptr);
    void (*data_transfer_stop)(void);
    bool (*is_data_transfer_busy)(void);
}Tmag_Config_t;

/***********************************************************************************************************
 ********************************************* Exported objects ********************************************
 ***********************************************************************************************************/

extern Tmag_Config_t Tmag_Config[TMAG_SENSOR_NBR_MAX];

/***********************************************************************************************************
 ************************************** Exported function prototypes ***************************************
 ***********************************************************************************************************/

#endif  /* _TMAG_CFG_H_ */
