TomaszBednorz/BLDC_Controller/Software/DRV/Tmag5170/Cfg/tmag_if.h

#ifndef _TMAG_IF_H_
#define _TMAG_IF_H_

/***********************************************************************************************************
 ********************************************* Included files **********************************************
 ***********************************************************************************************************/

#include "hal_hall.h"

/***********************************************************************************************************
 ************************************************* Defines *************************************************
 ***********************************************************************************************************/

//comm
#define Tmag_TransferComplete()      Hal_Hall_TransmissionCompletedCallback()    

/***********************************************************************************************************
 *********************************************** Data types ************************************************
 ***********************************************************************************************************/

typedef enum
{
    TMAG_SENSOR_NBR_0,
    TMAG_SENSOR_NBR_1,
    TMAG_SENSOR_NBR_MAX
}Tmag_SensorNbr_t;

/***********************************************************************************************************
 ********************************************* Exported objects ********************************************
 ***********************************************************************************************************/

/***********************************************************************************************************
 ************************************** Exported function prototypes ***************************************
 ***********************************************************************************************************/

#endif  /* _TMAG_IF_H_ */
