TomaszBednorz/BLDC_Controller/Software/DRV/Tmag5170/Src/tmag.h

#ifndef _TMAG_H_
#define _TAMG_H_

/***********************************************************************************************************
 ********************************************* Included files **********************************************
 ***********************************************************************************************************/

#include <stdint.h>
#include "tmag_if.h"

/***********************************************************************************************************
 ************************************************* Defines *************************************************
 ***********************************************************************************************************/

/***********************************************************************************************************
 *********************************************** Data types ************************************************
 ***********************************************************************************************************/

typedef enum
{
    TMAG_DATA_MAG_FIELD_X = 0U,
    TMAG_DATA_MAG_FIELD_Y,
    TMAG_DATA_MAG_FIELD_Z,
    TMAG_DATA_TEMPERATURE,
    TMAG_DATA_ANGLE,
    TMAG_DATA_AFE_STATUS,
    TMAG_DATA_SYS_STATUS
}Tmag_DataType_t;

/***********************************************************************************************************
 ********************************************* Exported objects ********************************************
 ***********************************************************************************************************/

/***********************************************************************************************************
 ************************************** Exported function prototypes ***************************************
 ***********************************************************************************************************/

void Tmag_Init(void);
void Tmag_TransferStart(const Tmag_SensorNbr_t sensor, const Tmag_DataType_t data_type);
void Tmag_TransferReady(void);
uint16_t Tmag_GetData(const Tmag_SensorNbr_t sensor, const Tmag_DataType_t data_type);

#endif  /* _TMAG_H_ */
