TomaszBednorz/BLDC_Controller/Software/HAL/Hal_Adc/Cfg/hal_adc_if.h

#ifndef _HAL_ADC_IF_H_
#define _HAL_ADC_IF_H_

/***********************************************************************************************************
 ********************************************* Included files **********************************************
 ***********************************************************************************************************/

#include "ADC_MEASUREMENT_ADV/adc_measurement_adv.h"
#include "hal_adc_cfg.h"

/***********************************************************************************************************
 ************************************************* Defines *************************************************
 ***********************************************************************************************************/

#define HAL_ADC_TASK_PERIOD  (2U)  /* 1 = 1000us */

#define Hal_Adc_Start()  \
    ADC_MEASUREMENT_ADV_StartADC(&ADC_G0); \
    ADC_MEASUREMENT_ADV_StartADC(&ADC_G1)


#define Hal_Adc_Trigger()  \
    ADC_MEASUREMENT_ADV_SoftwareTrigger(&ADC_G0); \
    ADC_MEASUREMENT_ADV_SoftwareTrigger(&ADC_G1)


/***********************************************************************************************************
 *********************************************** Data types ************************************************
 ***********************************************************************************************************/

typedef struct
{
    uint8_t instance[HAL_ADC_CHANNEL_MAX];
    uint8_t idx[HAL_ADC_CHANNEL_MAX];
    ADC_MEASUREMENT_ADV_CHANNEL_t* handler[HAL_ADC_CHANNEL_MAX];
}Hal_Adc_Config_t;

/***********************************************************************************************************
 ********************************************* Exported objects ********************************************
 ***********************************************************************************************************/

extern const Hal_Adc_Config_t Hal_Adc_Config[HAL_ADC_GROUP_MAX];

/***********************************************************************************************************
 ************************************** Exported function prototypes ***************************************
 ***********************************************************************************************************/

#endif  /* _HAL_ADC_IF_H_ */
