TomaszBednorz/BLDC_Controller/(commit log)

2024-06-05 Add Altium designer project
    [2023960807.SchLib, 43860-0010_RJ45.SchLib, 438600010_RJ45.PcbLib, CAPACITOR.SchLib, CONNECTOR.SchLib, DIODE.SchLib, ECAT0_(IN).SchDoc, ECAT1_(OUT).SchDoc]
2024-06-05 Add custom encoder electrical schematic
2024-06-05 Add BLDC driver software
